cmu-argus-2/Avionics-Minus-Z/-Z.step

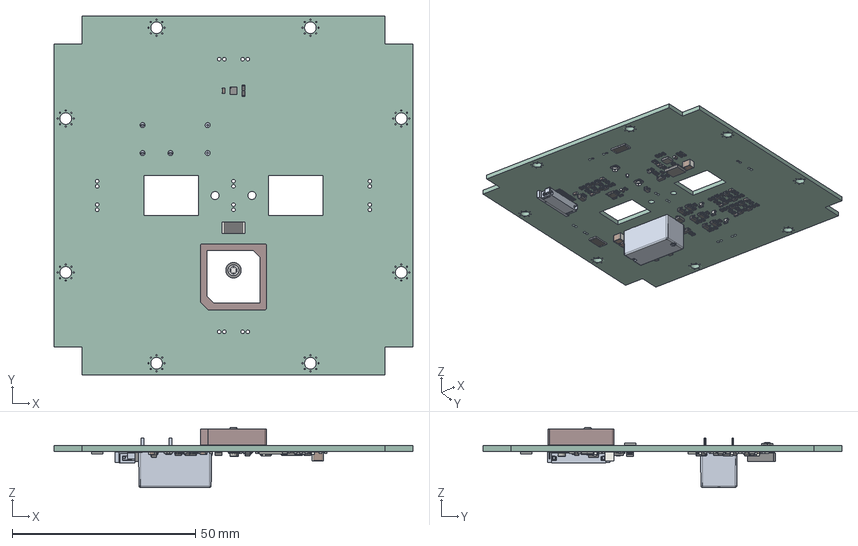
[picture p1: CAD file, 2026-02-09]
-Z.step
98.0 x 98.0 x 16.5 mm
R_0603_1608Metric x 75
OPT4003DNPRQ1
CGGBP.18.4.A.02--3DModel-STEP-510211
C_0603_1608Metric x 12
R_2512_6332Metric x 3
TSOP-6_1.65x3.05mm_P0.95mm x 3
LED_0603_1608Metric x 5
U.FL_Hirose_U.FL-R-SMT-1_Vertical x 2
Fuse_0603_1608Metric x 6
SOT-363_SC-70-6 x 12
TSSOP-10_3x3mm_P0.5mm
SOT-23 x 5
C_1210_3225Metric x 3
SIRA99DP-T1-GE3
SOT-23-6
ATB2012-50011-T000
Pins
BODY-QFN
PIN1-ID
D_PowerDI-123
-Z_PCB
