cmu-argus-2/Avionics-Minus-Z/(list of files, cad)

Other CAD files:
Variants/V5/-Z.step
Variants/V1/-Z.step
Variants/V2/-Z.step
Variants/V3/-Z.step
Variants/V4/-Z.step
