cmu-argus-2/Avionics-Minus-Z/-Z.kicad_sch

## KiCad design -Z.kicad_sch (2026-03-23)

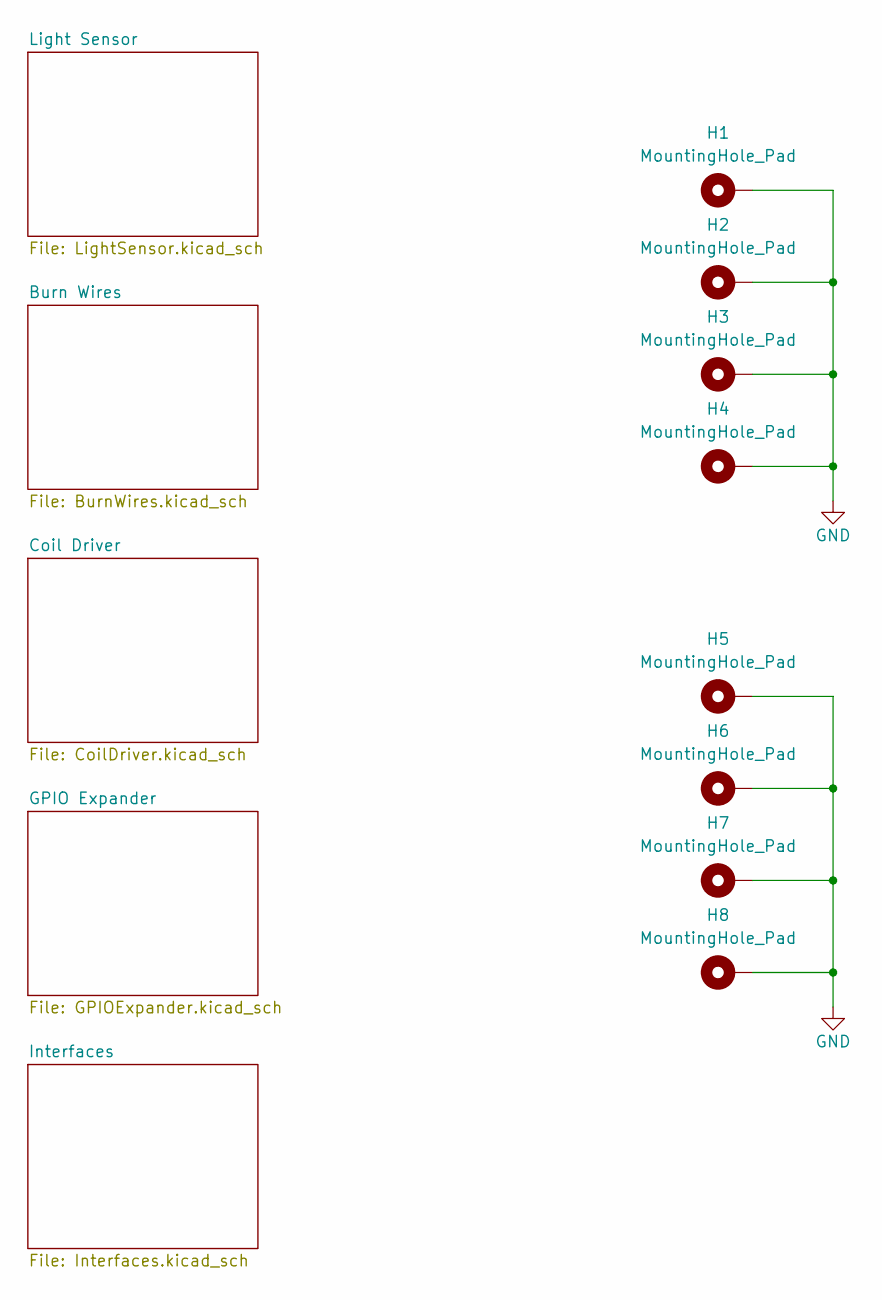
[picture p2: schematic -Z.kicad_sch]

Parts:
H1, H2, H3, H4, H5, H6, H7, H8: MountingHole_Pad; MountingHole_3.2mm_M3_DIN965_Pad_TopBottom

Connections:
GND: H1.1, H2.1, H3.1, H4.1, H5.1, H6.1, H7.1, H8.1
