cmu-argus-2/Avionics-Minus-Z/BurnWires.kicad_sch

## KiCad design BurnWires.kicad_sch (2026-03-23)

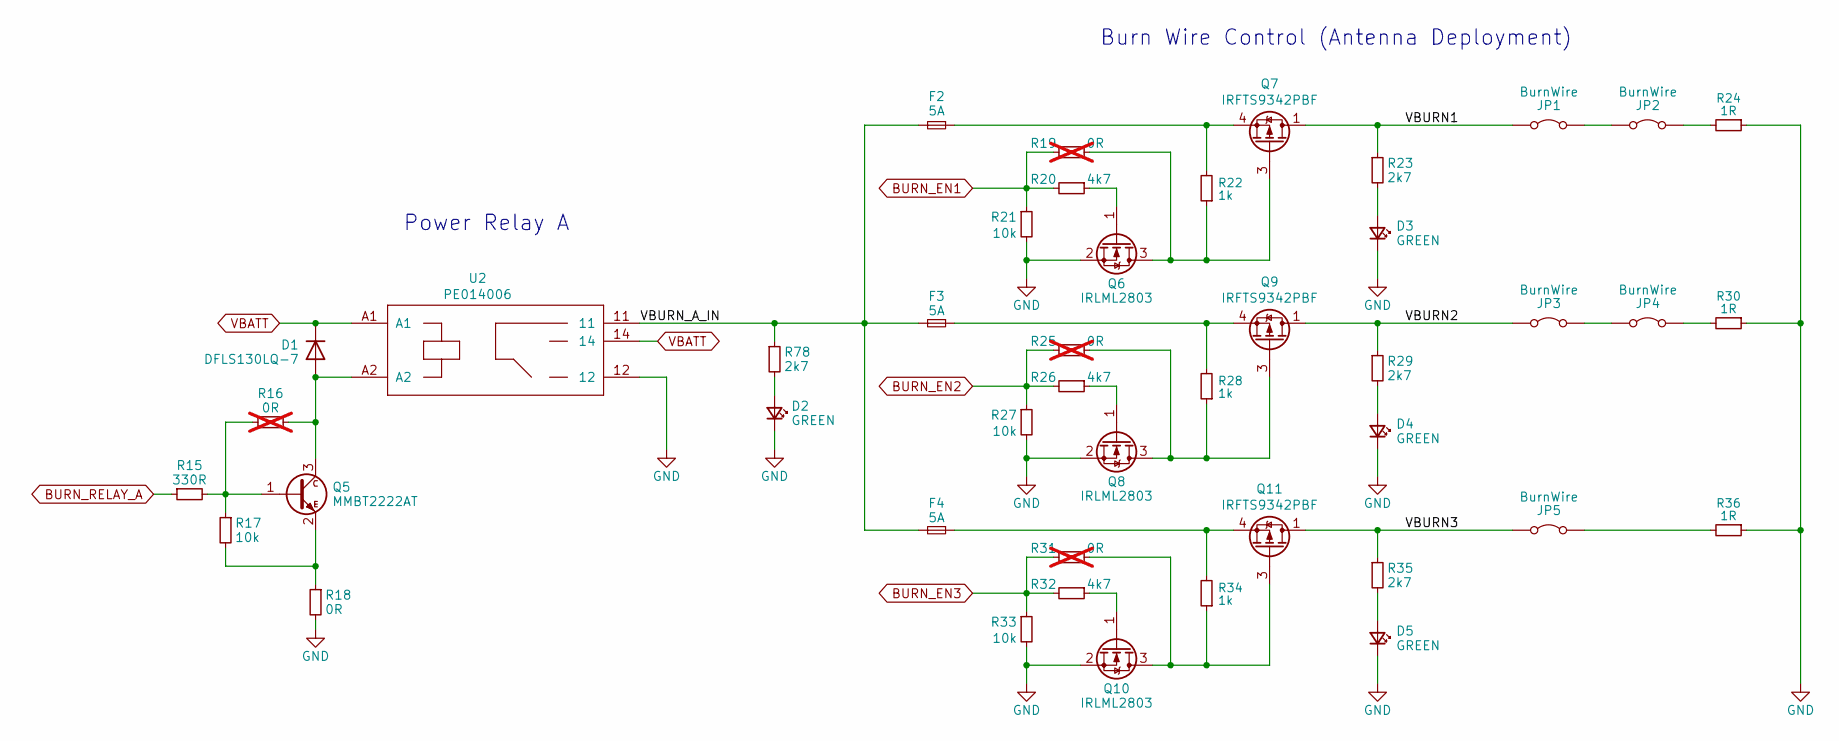
[picture p3: schematic BurnWires.kicad_sch]

Parts:
D1: DFLS130LQ-7; D_PowerDI-123
D2, D3, D4, D5: GREEN; LED_0603_1608Metric; MPN IN-S63AT5A
F2, F3, F4: 5A; Fuse_0603_1608Metric
JP1, JP2, JP3, JP4, JP5: BurnWire; Burn-Wire
Q5: MMBT2222AT; SOT-23; Manufacturer_Part_Number MMBT2222ALT1G
Q6, Q8, Q10: IRLML2803; SOT-23
Q7, Q9, Q11: IRFTS9342PBF; TSOP-6_1.65x3.05mm_P0.95mm
R15: 330R; R_0603_1608Metric
R16, R19, R25, R31: 0R; R_0603_1608Metric; not fitted
R17, R21, R27, R33: 10k; R_0603_1608Metric
R18: 0R; R_0603_1608Metric
R20, R26, R32: 4k7; R_0603_1608Metric
R22, R28, R34: 1k; R_0603_1608Metric
R23, R29, R35, R78: 2k7; R_0603_1608Metric; MPN CRGCQ0603F2K7
R24, R30, R36: 1R; R_2512_6332Metric
U2: PE014006; RELAY_PE014006; Manufacturer_Part_Number PE014006 TE

Connections:
BURN_EN1: R19.2, R20.2, R21.1
BURN_EN2: R25.2, R26.2, R27.1
BURN_EN3: R31.2, R32.2, R33.1
BURN_RELAY_A: R15.1
GND: D2.1 (K), D3.1 (K), D4.1 (K), D5.1 (K), Q6.2 (S), Q8.2 (S), Q10.2 (S), R18.2, R21.2, R24.1, R27.2, R30.1, R33.2, R36.1, U2.12
unnamed: D1.2 (A), Q5.3 (C), R16.2, U2.A2
unnamed: D2.2 (A), R78.2
unnamed: D3.2 (A), R23.2
unnamed: D4.2 (A), R29.2
unnamed: D5.2 (A), R35.2
unnamed: F2.1, Q7.4 (S), R22.2
unnamed: F3.1, Q9.4 (S), R28.2
unnamed: F4.1, Q11.4 (S), R34.2
unnamed: JP1.2 (B), JP2.1 (A)
unnamed: JP2.2 (B), R24.2
unnamed: JP3.2 (B), JP4.1 (A)
unnamed: JP4.2 (B), R30.2
unnamed: JP5.2 (B), R36.2
unnamed: Q5.1 (B), R15.2, R16.1, R17.1
unnamed: Q5.2 (E), R17.2, R18.1
unnamed: Q6.1 (G), R20.1
unnamed: Q6.3 (D), Q7.3 (G), R19.1, R22.1
unnamed: Q8.1 (G), R26.1
unnamed: Q8.3 (D), Q9.3 (G), R25.1, R28.1
unnamed: Q10.1 (G), R32.1
unnamed: Q10.3 (D), Q11.3 (G), R31.1, R34.1
VBATT: D1.1 (K), U2.14, U2.A1
VBURN1: JP1.1 (A), Q7.1 (D), Q7.2 (D), Q7.5 (D), Q7.6 (D), R23.1
VBURN2: JP3.1 (A), Q9.1 (D), Q9.2 (D), Q9.5 (D), Q9.6 (D), R29.1
VBURN3: JP5.1 (A), Q11.1 (D), Q11.2 (D), Q11.5 (D), Q11.6 (D), R35.1
VBURN_A_IN: F2.2, F3.2, F4.2, R78.1, U2.11

Notes on the sheet:
Burn Wire Control (Antenna Deployment)
Power Relay A
