cmu-argus-2/Avionics-Minus-Z/CoilDriver.kicad_sch

## KiCad design CoilDriver.kicad_sch (2026-03-23)

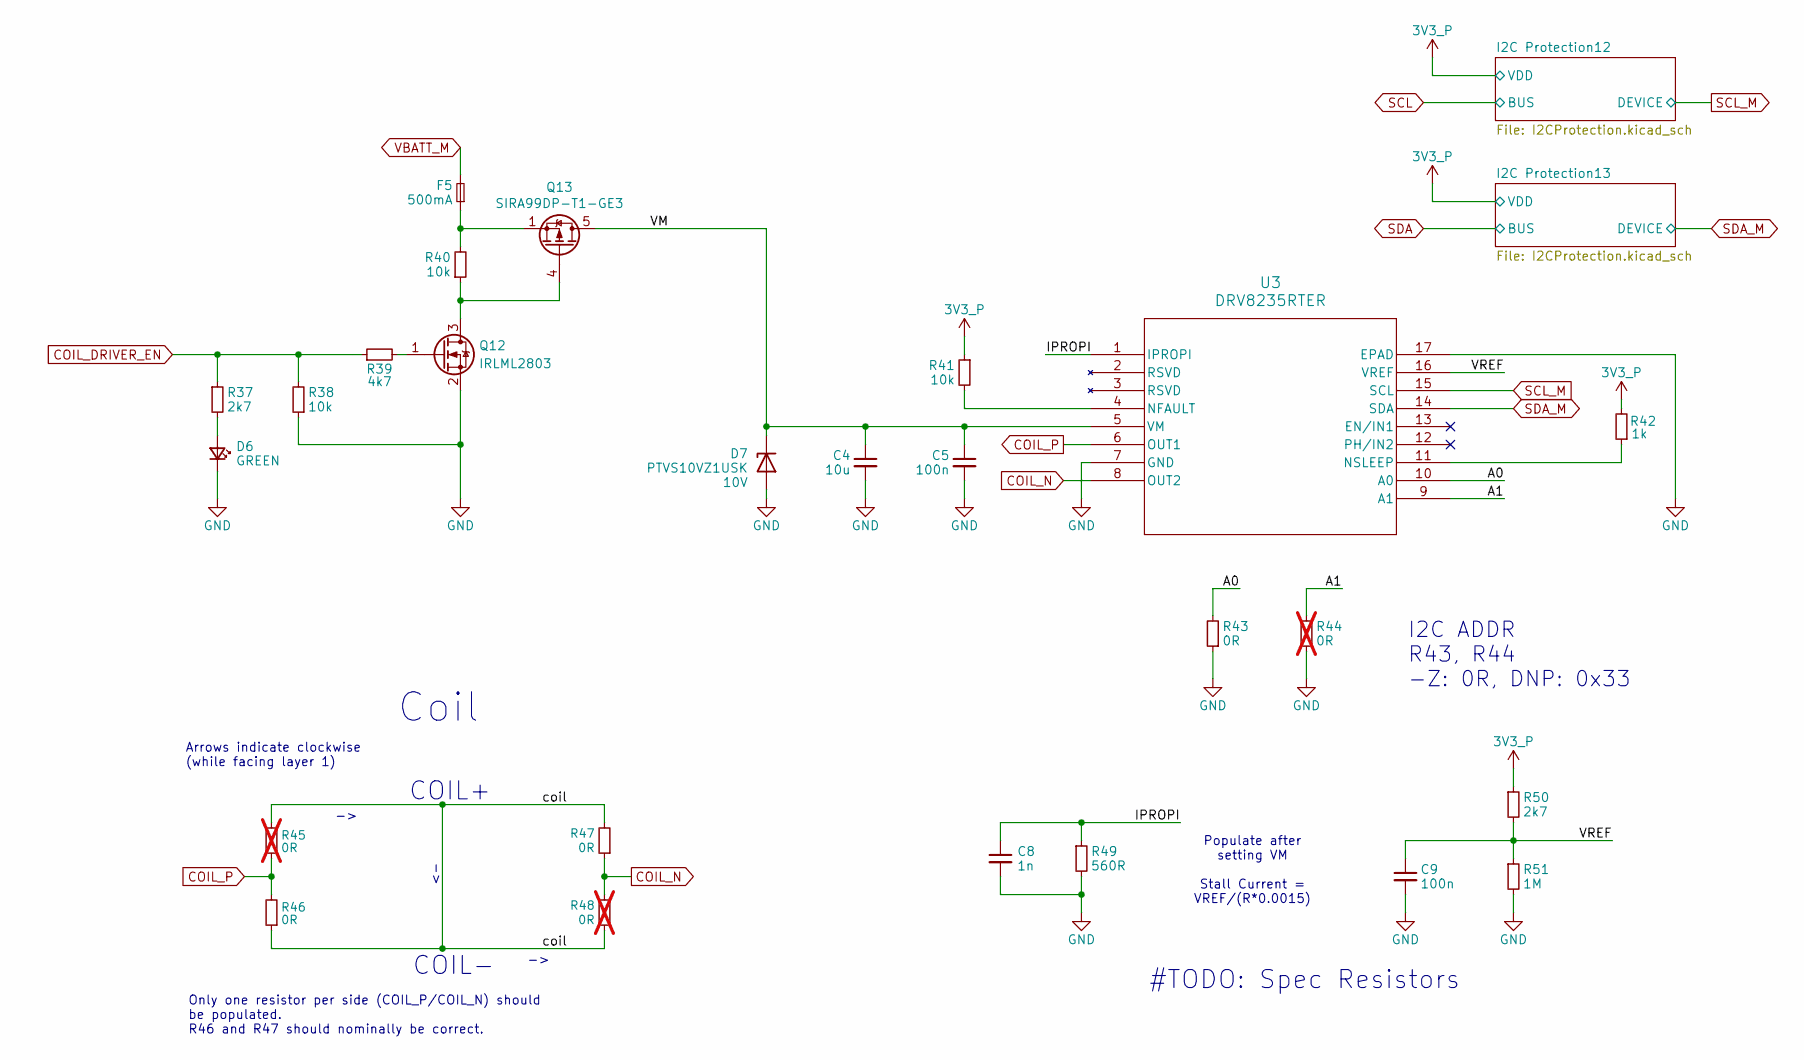
[picture p4: schematic CoilDriver.kicad_sch]

Parts:
C4: 10u; C_1210_3225Metric
C5, C9: 100n; C_0603_1608Metric
C8: 1n; C_0603_1608Metric
D6: GREEN; LED_0603_1608Metric; MPN IN-S63AT5A
D7: PTVS10VZ1USK; Nexperia_DSN1608-2_1.6x0.8mm
F5: 500mA; Fuse_0603_1608Metric
Q12: IRLML2803; SOT-23
Q13: SIRA99DP-T1-GE3; PowerPAK_SO-8_Single; MPN C3289459
R37: 2k7; R_0603_1608Metric; MPN CRGCQ0603F2K7
R38, R40: 10k; R_0603_1608Metric; MPN RC0603FR-0710KL
R39: 4k7; R_0603_1608Metric
R41: 10k; R_0603_1608Metric
R42: 1k; R_0603_1608Metric
R43, R46, R47: 0R; R_0603_1608Metric
R44, R45, R48: 0R; R_0603_1608Metric; not fitted
R49: 560R; R_0603_1608Metric
R50: 2k7; R_0603_1608Metric
R51: 1M; R_0603_1608Metric
U3: DRV8235RTER; WQFN16_RTE_TEX

Connections:
3V3_P: R41.1, R42.2, R50.1
A0: R43.2, U3.10 (A0)
A1: R44.2, U3.9 (A1)
COIL_DRIVER_EN: R37.1, R38.2, R39.1
COIL_N: R47.1, R48.2, U3.8 (OUT2)
COIL_P: R45.1, R46.2, U3.6 (OUT1)
GND: C4.2, C5.2, C8.2, C9.2, D6.1 (K), D7.2 (A), Q12.2 (S), R38.1, R43.1, R44.1, R49.2, R51.2, U3.7 (GND), U3.17 (EPAD)
IPROPI: C8.1, R49.1, U3.1 (IPROPI)
unnamed: D6.2 (A), R37.2
unnamed: F5.1, Q13.1 (S), Q13.2 (S), Q13.3 (S), R40.2
unnamed: Q12.1 (G), R39.2
unnamed: Q12.3 (D), Q13.4 (G), R40.1
unnamed: R41.2, U3.4 (NFAULT)
unnamed: R42.1, U3.11 (NSLEEP)
SCL_M: U3.15 (SCL)
SDA_M: U3.14 (SDA)
VBATT_M: F5.2
VM: C4.1, C5.1, D7.1 (K), Q13.5 (D), U3.5 (VM)
VREF: C9.1, R50.2, R51.1, U3.16 (VREF)
coil: R45.2, R46.1, R47.2, R48.1

Notes on the sheet:
COIL+
#TODO: Spec Resistors
Coil
I2C ADDR R43, R44 -Z: 0R, DNP: 0x33
Only one resistor per side (COIL_P/COIL_N) should be populated. R46 and R47 should nominally be correct.
Arrows indicate clockwise (while facing layer 1)
COIL-
Populate after setting VM Stall Current = VREF/(R*0.0015)
