cmu-argus-2/Avionics-Minus-Z/GPIOExpander.kicad_sch

## KiCad design GPIOExpander.kicad_sch (2026-03-23)

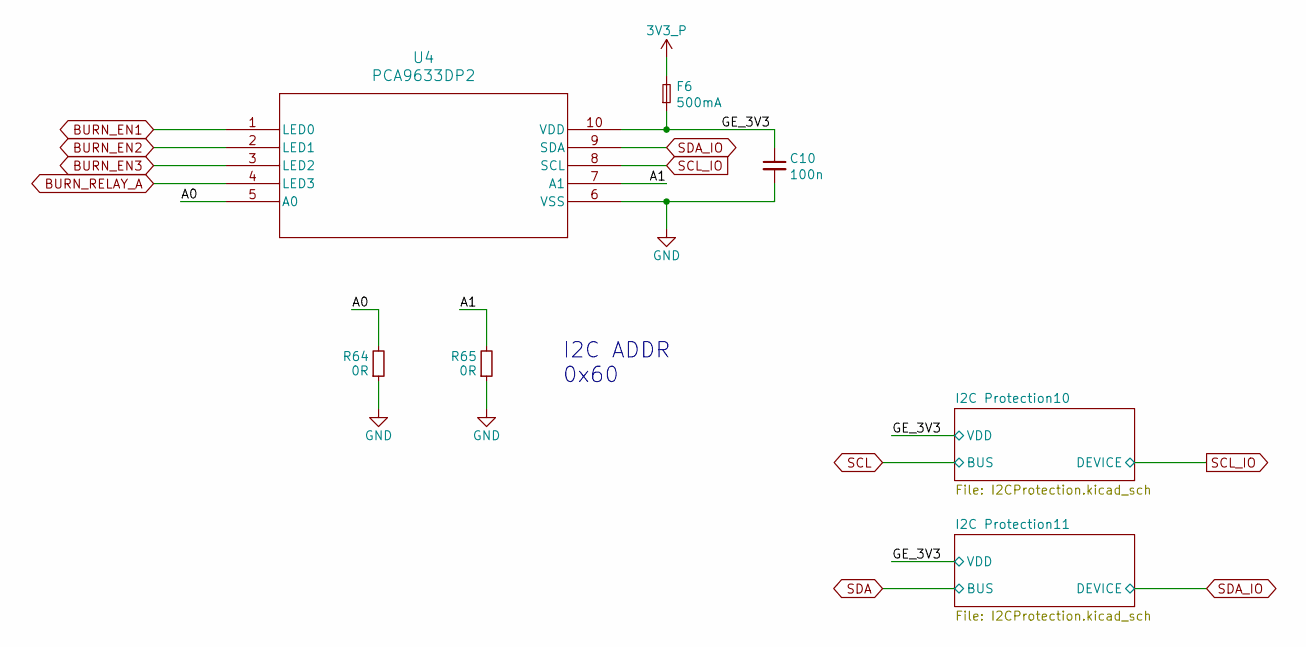
[picture p5: schematic GPIOExpander.kicad_sch]

Parts:
C10: 100n; C_0603_1608Metric
F6: 500mA; Fuse_0603_1608Metric
R64, R65: 0R; R_0603_1608Metric
U4: PCA9633DP2; SOT552-1_NXP

Connections:
3V3_P: F6.2
A0: R64.2, U4.5 (A0)
A1: R65.2, U4.7 (A1)
BURN_EN1: U4.1 (LED0)
BURN_EN2: U4.2 (LED1)
BURN_EN3: U4.3 (LED2)
BURN_RELAY_A: U4.4 (LED3)
GE_3V3: C10.1, F6.1, U4.10 (VDD)
GND: C10.2, R64.1, R65.1, U4.6 (VSS)
SCL_IO: U4.8 (SCL)
SDA_IO: U4.9 (SDA)

Notes on the sheet:
I2C ADDR 0x60
