cmu-argus-2/Avionics-Minus-Z/I2CProtection.kicad_sch

## KiCad design I2CProtection.kicad_sch (2026-03-23)

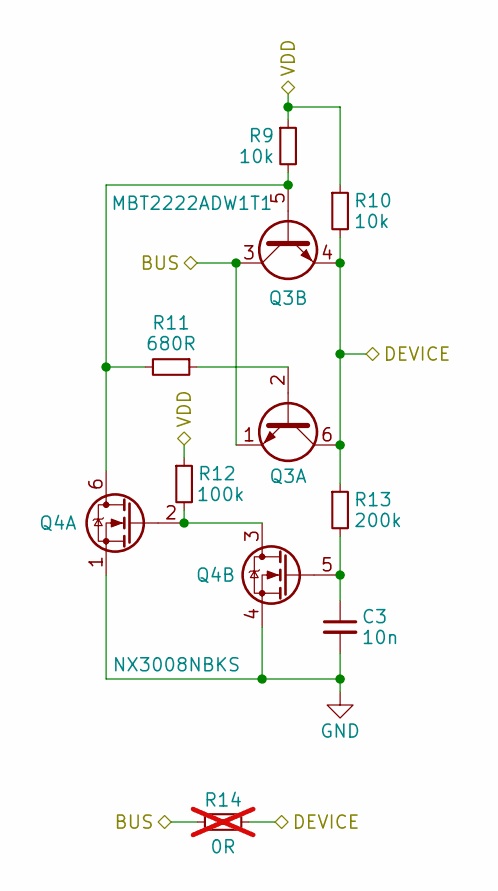
[picture p6: schematic I2CProtection.kicad_sch]

Parts:
C3: 10n; C_0603_1608Metric
Q3: MBT2222ADW1T1; SOT-363_SC-70-6; Manufacturer_Part_Number MBT2222ADW1T1G
Q4: NX3008NBKS; SOT-363_SC-70-6; Manufacturer_Part_Number NX3008NBKS
R9, R10: 10k; R_0603_1608Metric
R11: 680R; R_0603_1608Metric
R12: 100k; R_0603_1608Metric
R13: 200k; R_0603_1608Metric
R14: 0R; R_0603_1608Metric; not fitted

Connections:
BUS: Q3.1 (E1), Q3.3 (C2), R14.2
DEVICE: Q3.4 (E2), Q3.6 (C1), R10.2, R13.1, R14.1
GND: C3.2, Q4.1 (S2), Q4.4 (S1)
unnamed: C3.1, Q4.5 (G1), R13.2
unnamed: Q3.2 (B1), R11.1
unnamed: Q3.5 (B2), Q4.6 (D1), R9.2, R11.2
unnamed: Q4.2 (G2), Q4.3 (D2), R12.2
VDD: R9.1, R10.1, R12.1
