cmu-argus-2/Avionics-Minus-Z/Interfaces.kicad_sch

## KiCad design Interfaces.kicad_sch (2026-03-23)

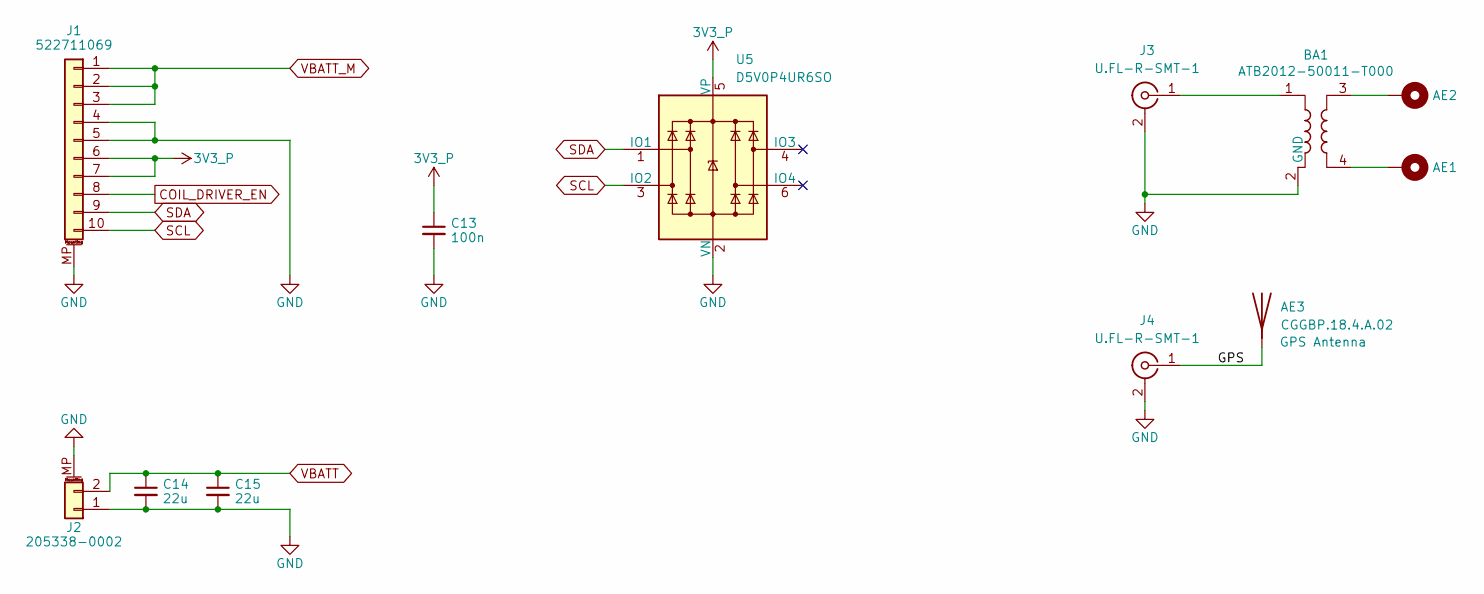
[picture p7: schematic Interfaces.kicad_sch]

Parts:
AE1, AE2: MountingHole_Pad; Antenna Mount v6
AE3: CGGBP.18.4.A.02; ANT_CGGBP.18.4.A.02_TAL
BA1: ATB2012-50011-T000; ATB2012
C13: 100n; C_0603_1608Metric; MPN C307348
C14, C15: 22u; C_1210_3225Metric; MPN C307348
J1: 522711069; CON_522711069_MOL
J2: 205338-0002; Molex_Pico-Lock_205338-0002_1x02-1MP_P2.00mm_Horizontal
J3, J4: U.FL-R-SMT-1; U.FL_Hirose_U.FL-R-SMT-1_Vertical
U5: D5V0P4UR6SO; SOT-23-6; MPN C531179

Connections:
3V3_P: C13.1, J1.6, J1.7, U5.5 (VP)
COIL_DRIVER_EN: J1.8
GND: BA1.2 (GND), C13.2, C14.2, C15.2, J1.4, J1.5, J1.MP (MountPin), J2.1, J2.MP (MountPin), J3.2 (Ext), J4.2 (Ext), U5.2 (VN)
GPS: AE3.1, J4.1 (In)
unnamed: AE1.1, BA1.4
unnamed: AE2.1, BA1.3
unnamed: BA1.1, J3.1 (In)
SCL: J1.10, U5.3 (IO2)
SDA: J1.9, U5.1 (IO1)
VBATT: C14.1, C15.1, J2.2
VBATT_M: J1.1, J1.2, J1.3
