cmu-argus-2/Avionics-Minus-Z/LightSensor.kicad_sch

## KiCad design LightSensor.kicad_sch (2026-03-23)

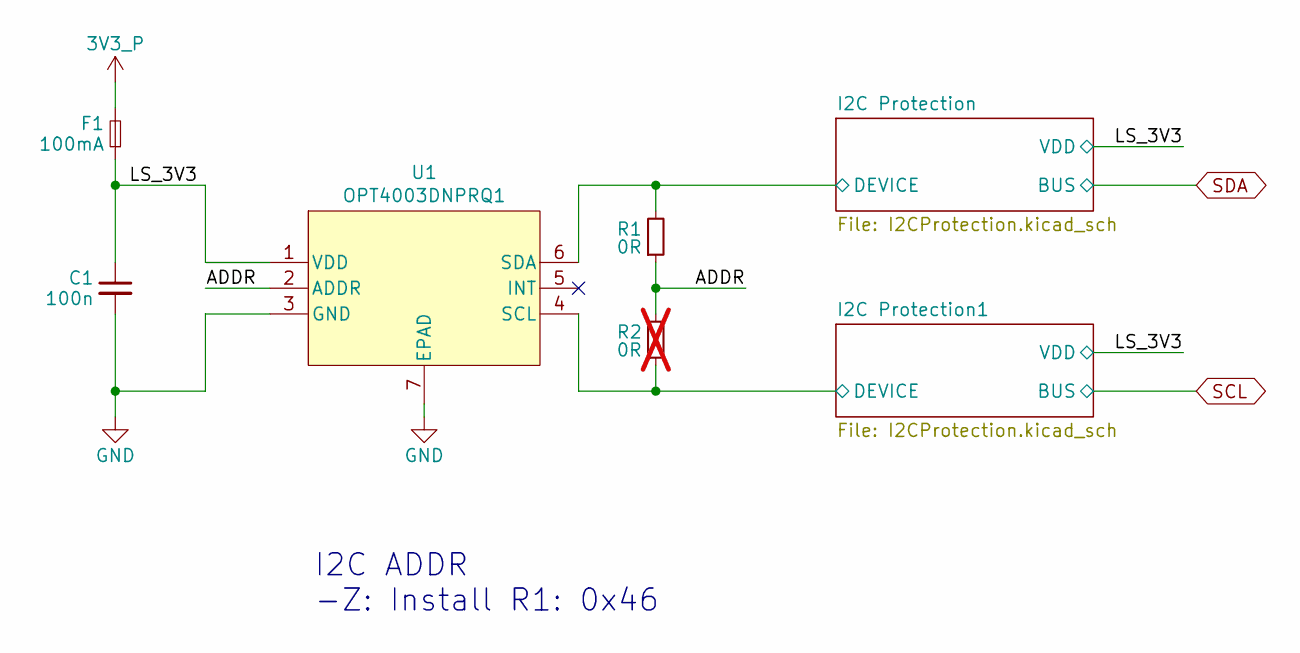
[picture p8: schematic LightSensor.kicad_sch]

Parts:
C1: 100n; C_0603_1608Metric
F1: 100mA; Fuse_0603_1608Metric
R1: 0R; R_0603_1608Metric
R2: 0R; R_0603_1608Metric; not fitted
U1: OPT4003DNPRQ1; OPT4003

Connections:
3V3_P: F1.2
ADDR: R1.1, R2.2, U1.2 (ADDR)
DEVICE: R1.2, R2.1, U1.4 (SCL), U1.6 (SDA)
GND: C1.2, U1.3 (GND), U1.7 (EPAD)
LS_3V3: C1.1, F1.1, U1.1 (VDD)

Notes on the sheet:
I2C ADDR -Z: Install R1: 0x46
