cmu-argus-2/Avionics-Minus-Z/Variants/V5/I2CDevices.kicad_sch

## KiCad design Variants/V5/I2CDevices.kicad_sch (2026-01-21)

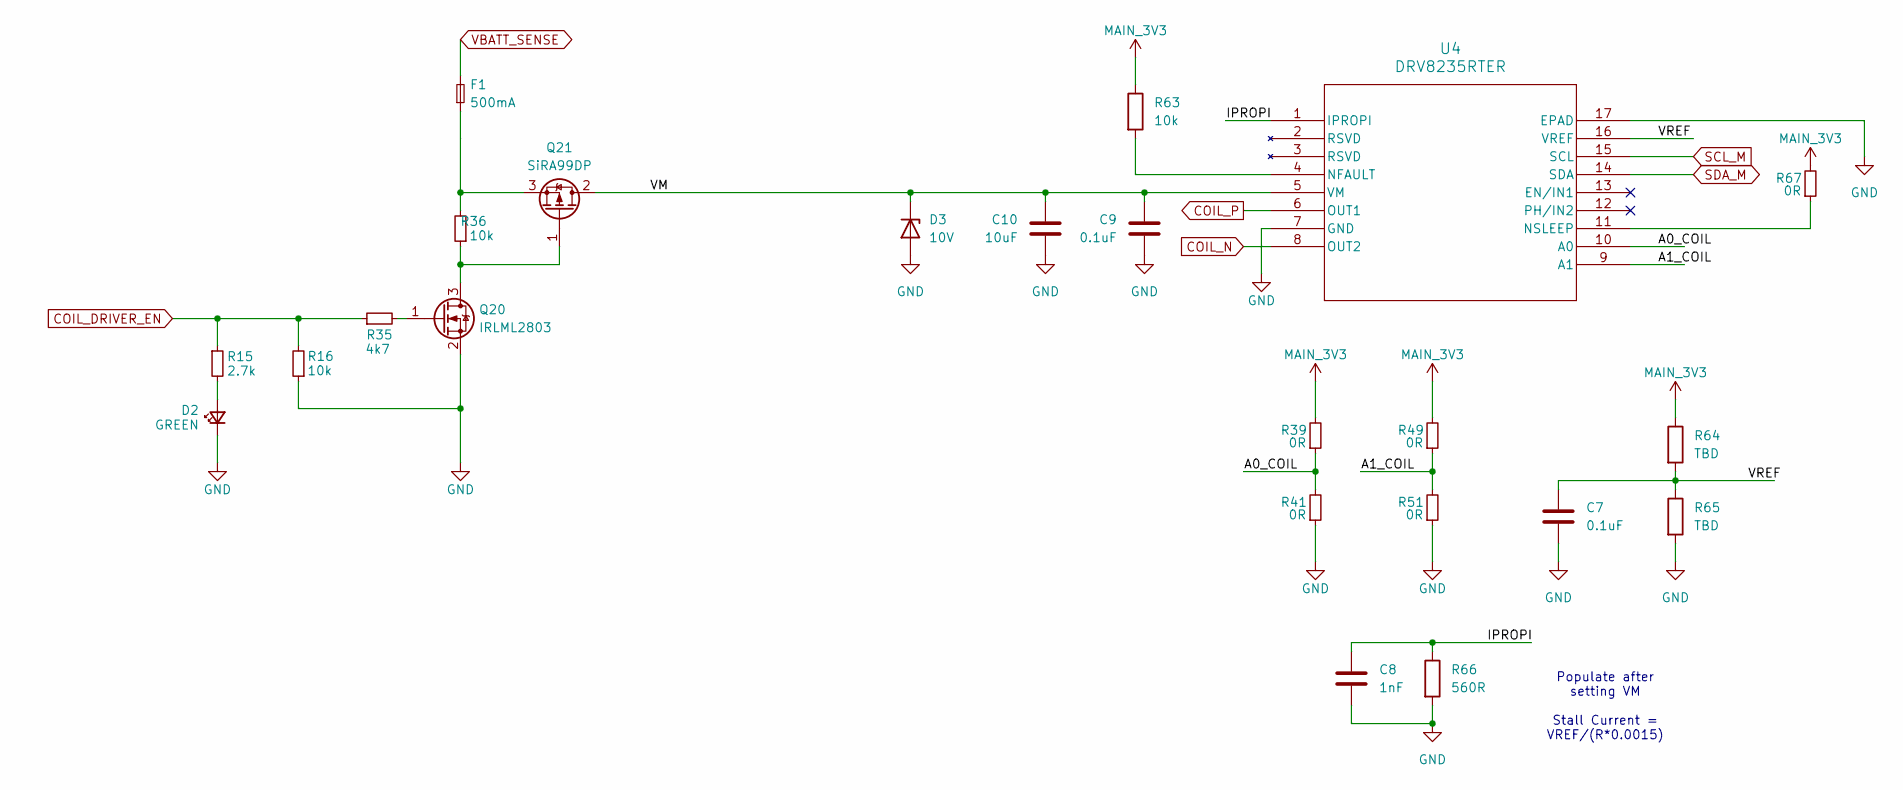
[picture p9: schematic I2CDevices.kicad_sch]

Parts:
C7, C9: 0.1uF; C_0603_1608Metric
C8: 1nF; C_0603_1608Metric
C10: 10uF; C_1206_3216Metric
D2: GREEN; LED_0603_1608Metric; MPN IN-S63AT5A
D3: 10V; Nexperia_DSN1608-2_1.6x0.8mm
F1: 500mA; Fuse_0603_1608Metric
Q20: IRLML2803; SOT-23
Q21: SiRA99DP; PowerPAK SO-8
R15: 2.7k; R_0603_1608Metric; MPN CRGCQ0603F2K7
R16, R36: 10k; R_0603_1608Metric; MPN RC0603FR-0710KL
R35: 4k7; R_0603_1608Metric
R39, R41, R49, R51, R67: 0R; R_0603_1608Metric
R63: 10k; R_0603_1608Metric
R64, R65: TBD; R_0603_1608Metric
R66: 560R; R_0603_1608Metric
U4: DRV8235RTER; WQFN16_RTE_TEX

Connections:
A0_COIL: R39.1, R41.2, U4.10 (A0)
A1_COIL: R49.1, R51.2, U4.9 (A1)
COIL_DRIVER_EN: R15.1, R16.2, R35.1
COIL_N: U4.8 (OUT2)
COIL_P: U4.6 (OUT1)
GND: C7.2, C8.2, C9.2, C10.2, D2.1 (K), D3.2 (A), Q20.2 (S), R16.1, R41.1, R51.1, R65.2, R66.2, U4.7 (GND), U4.17 (EPAD)
IPROPI: C8.1, R66.1, U4.1 (IPROPI)
MAIN_3V3: R39.2, R49.2, R63.1, R64.1, R67.2
unnamed: D2.2 (A), R15.2
unnamed: F1.1, Q21.3 (S), R36.2
unnamed: Q20.1 (G), R35.2
unnamed: Q20.3 (D), Q21.1 (G), R36.1
unnamed: R63.2, U4.4 (NFAULT)
unnamed: R67.1, U4.11 (NSLEEP)
SCL_M: U4.15 (SCL)
SDA_M: U4.14 (SDA)
VBATT_SENSE: F1.2
VM: C9.1, C10.1, D3.1 (K), Q21.2 (D), U4.5 (VM)
VREF: C7.1, R64.2, R65.1, U4.16 (VREF)

Notes on the sheet:
Populate after setting VM Stall Current = VREF/(R*0.0015)
