cmu-argus-2/Avionics-Minus-Z/(commit log)

2025-02-04 Updated filepaths
    [Avionics-SolarPanels.kicad_pcb, Avionics-SolarPanels.kicad_sch, BurnWires.kicad_sch, BusProtection.kicad_sch, ChargeOR.kicad_sch, I2CDevices.kicad_sch, I2CProtection.kicad_sch, MPPT.kicad_sch]
2025-02-13 Added more silkscreen, switched to PMOS instead of mech relay
    [BurnWires.kicad_sch, Z-.kicad_pcb]
2025-02-17 Added minus-z BOM
    [Minus-Z.xlsx]
2025-02-18 Updated burnwire footprint and fuse specs
    [BurnWires.kicad_sch, Z-.kicad_pcb]
2025-02-28 Minor layout tweaks and gerbers exported
    [Z--B_Cu.gbr, Z--B_Mask.gbr, Z--B_Paste.gbr, Z--B_Silkscreen.gbr, Z--Edge_Cuts.gbr, Z--F_Cu.gbr, Z--F_Mask.gbr, Z--F_Paste.gbr]
2025-03-01 Renamed gerber files
2025-03-07 Added temp step export
    [Z-.step]
2025-03-13 updated relay with old relay
    [BurnWires.kicad_sch, I2CDevices.kicad_sch, I2CProtection.kicad_sch, Z-.kicad_pcb, Z-.kicad_sch]
2025-03-13 Updated PCB
    [Z-.kicad_pcb]
2025-03-14 Done, still needs silkscreen
    [Z-.kicad_pcb]
2025-03-14 Updated silkscreen and gps/antenna parameters for 50ohm
    [Z-.kicad_pcb, Z-.kicad_sch]
2025-03-26 Updated burnwire circuitry and layout
    [BurnWires.kicad_sch, Z-.kicad_pcb]
2025-11-18 Stash 2
    [-Z-B_Cu.gbr, -Z-B_Mask.gbr, -Z-B_Paste.gbr, -Z-B_Silkscreen.gbr, -Z-Edge_Cuts.gbr, -Z-F_Cu.gbr, -Z-F_Mask.gbr, -Z-F_Paste.gbr]
2025-11-19 resistor values
    [BurnWires.kicad_sch]
2026-01-21 Update DNP list
    [BurnWires.kicad_sch]
2026-02-09 V6 Updates
    [-Z-B_Cu.gbr, -Z-B_Mask.gbr, -Z-B_Paste.gbr, -Z-B_Silkscreen.gbr, -Z-Edge_Cuts.gbr, -Z-F_Cu.gbr, -Z-F_Mask.gbr, -Z-F_Paste.gbr]
2026-03-23 Coil direction comment clarification
    [-Z.kicad_sch, BurnWires.kicad_sch, CoilDriver.kicad_sch, GPIOExpander.kicad_sch, I2CProtection.kicad_sch, Interfaces.kicad_sch, LightSensor.kicad_sch]
